mpstubler/legacy-scp-scpc-arduino-interface/(commit log)

2026-10-05 Rename pump no background.png to pump-saline-loop.png
2026-10-05 Rename Reverse-engineered pump command interface.png to system-overview.png
2026-10-06 Organize project files and add demo previews; video replacement pending
    [RECORDED_EXPENSES.csv]
